cscnitc/RP2040-Based-Fault-Injection-Tool/pcb/gerbers&schematics/Schematic.pdf

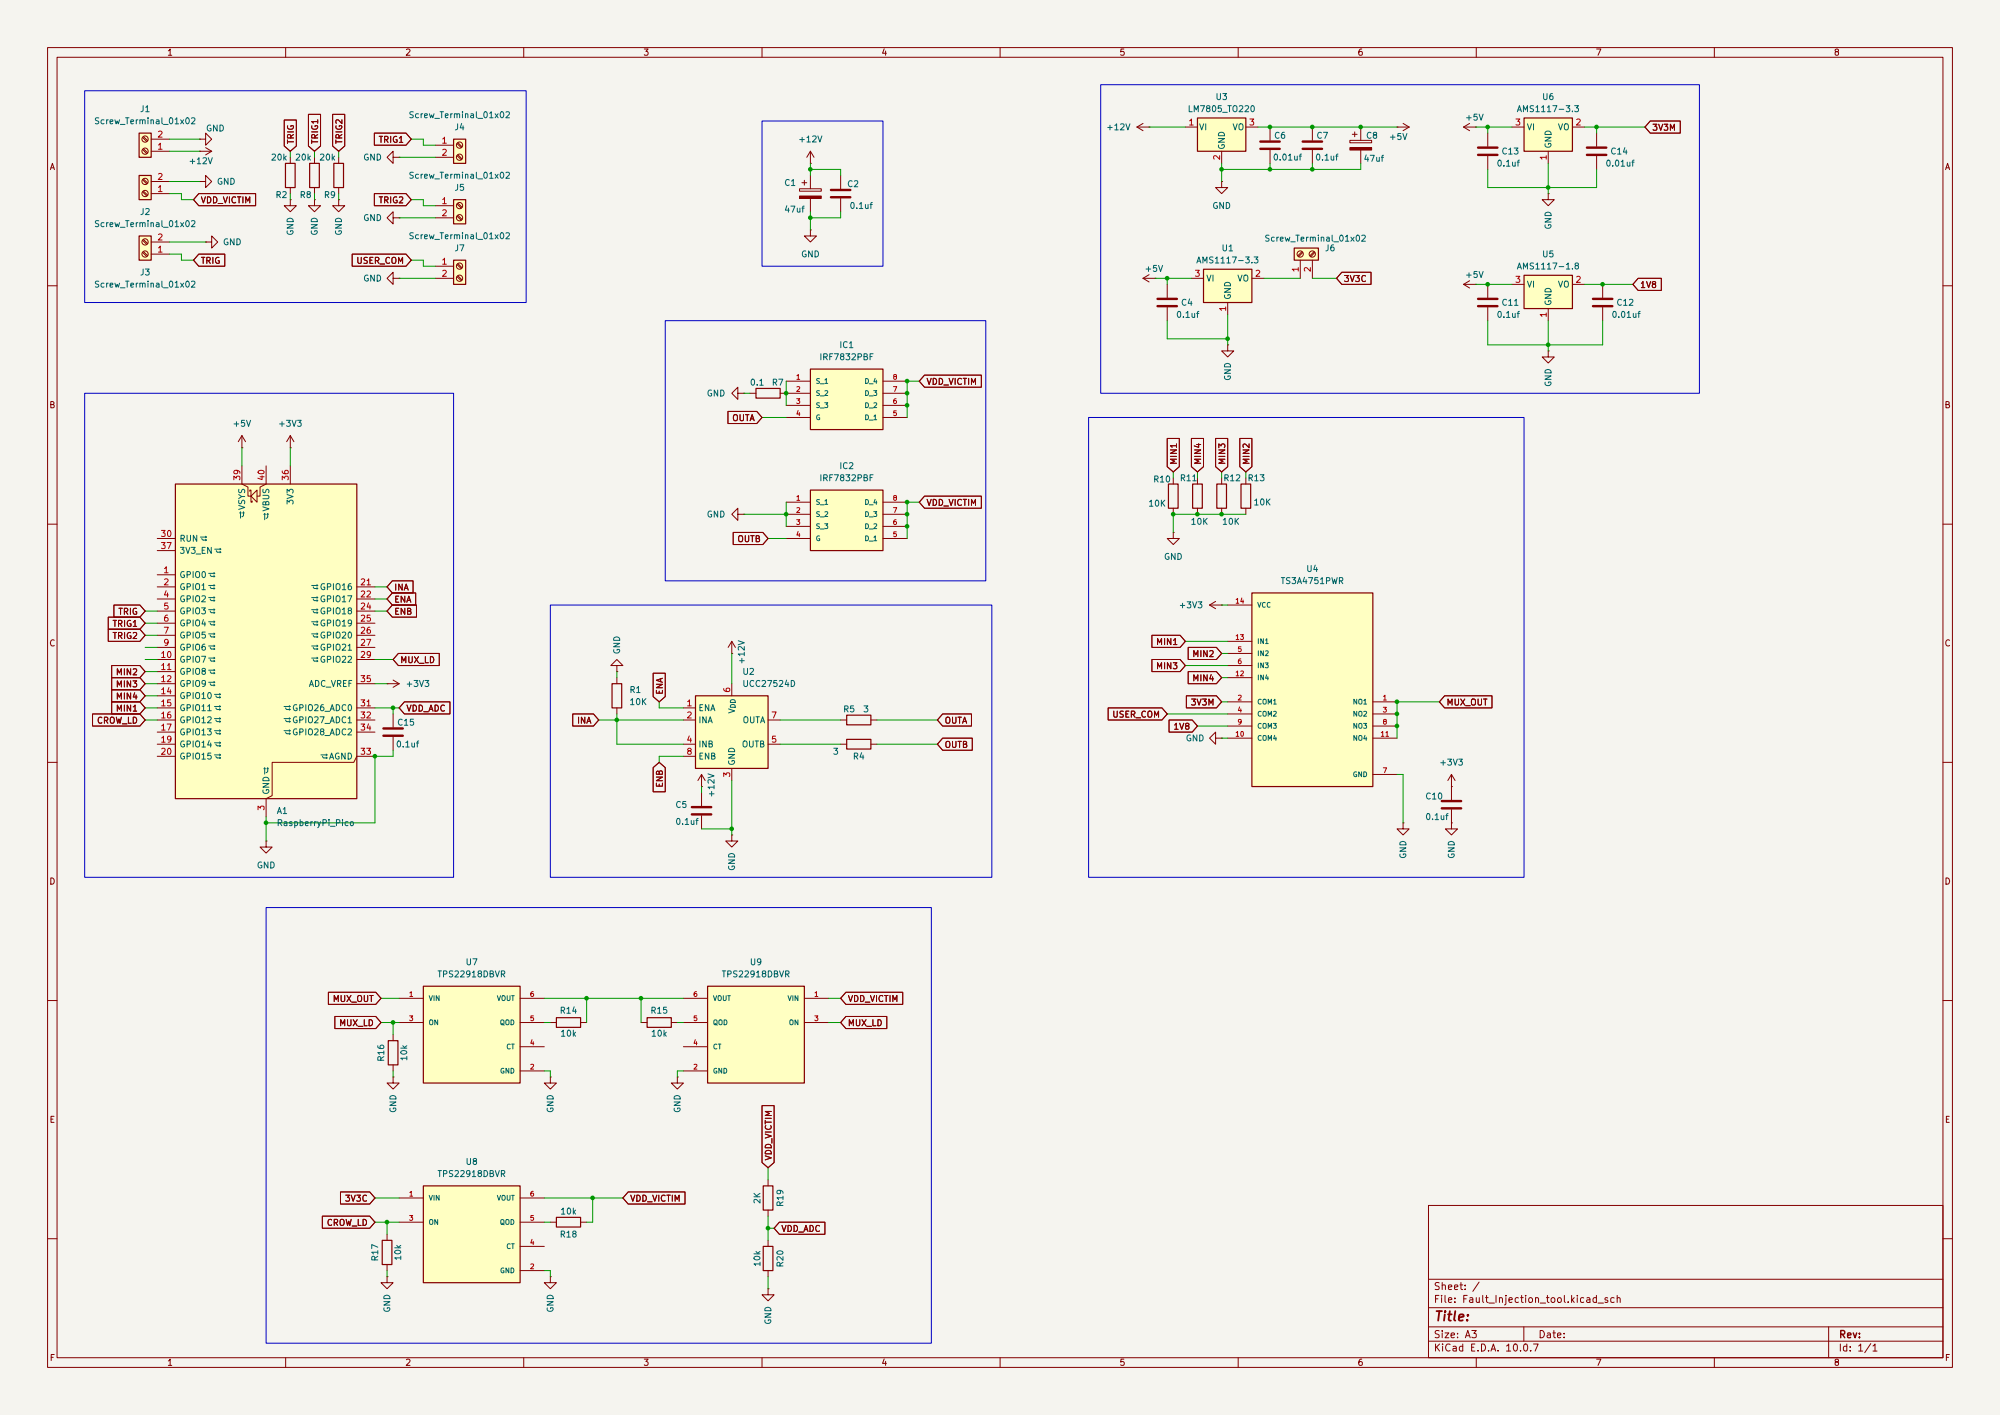
[picture p1: page 1]
