cscnitc/RP2040-Based-Fault-Injection-Tool/pcb/Fault_Injection_tool.kicad_pcb

## KiCad design pcb/Fault_Injection_tool.kicad_pcb (2026-11-07)

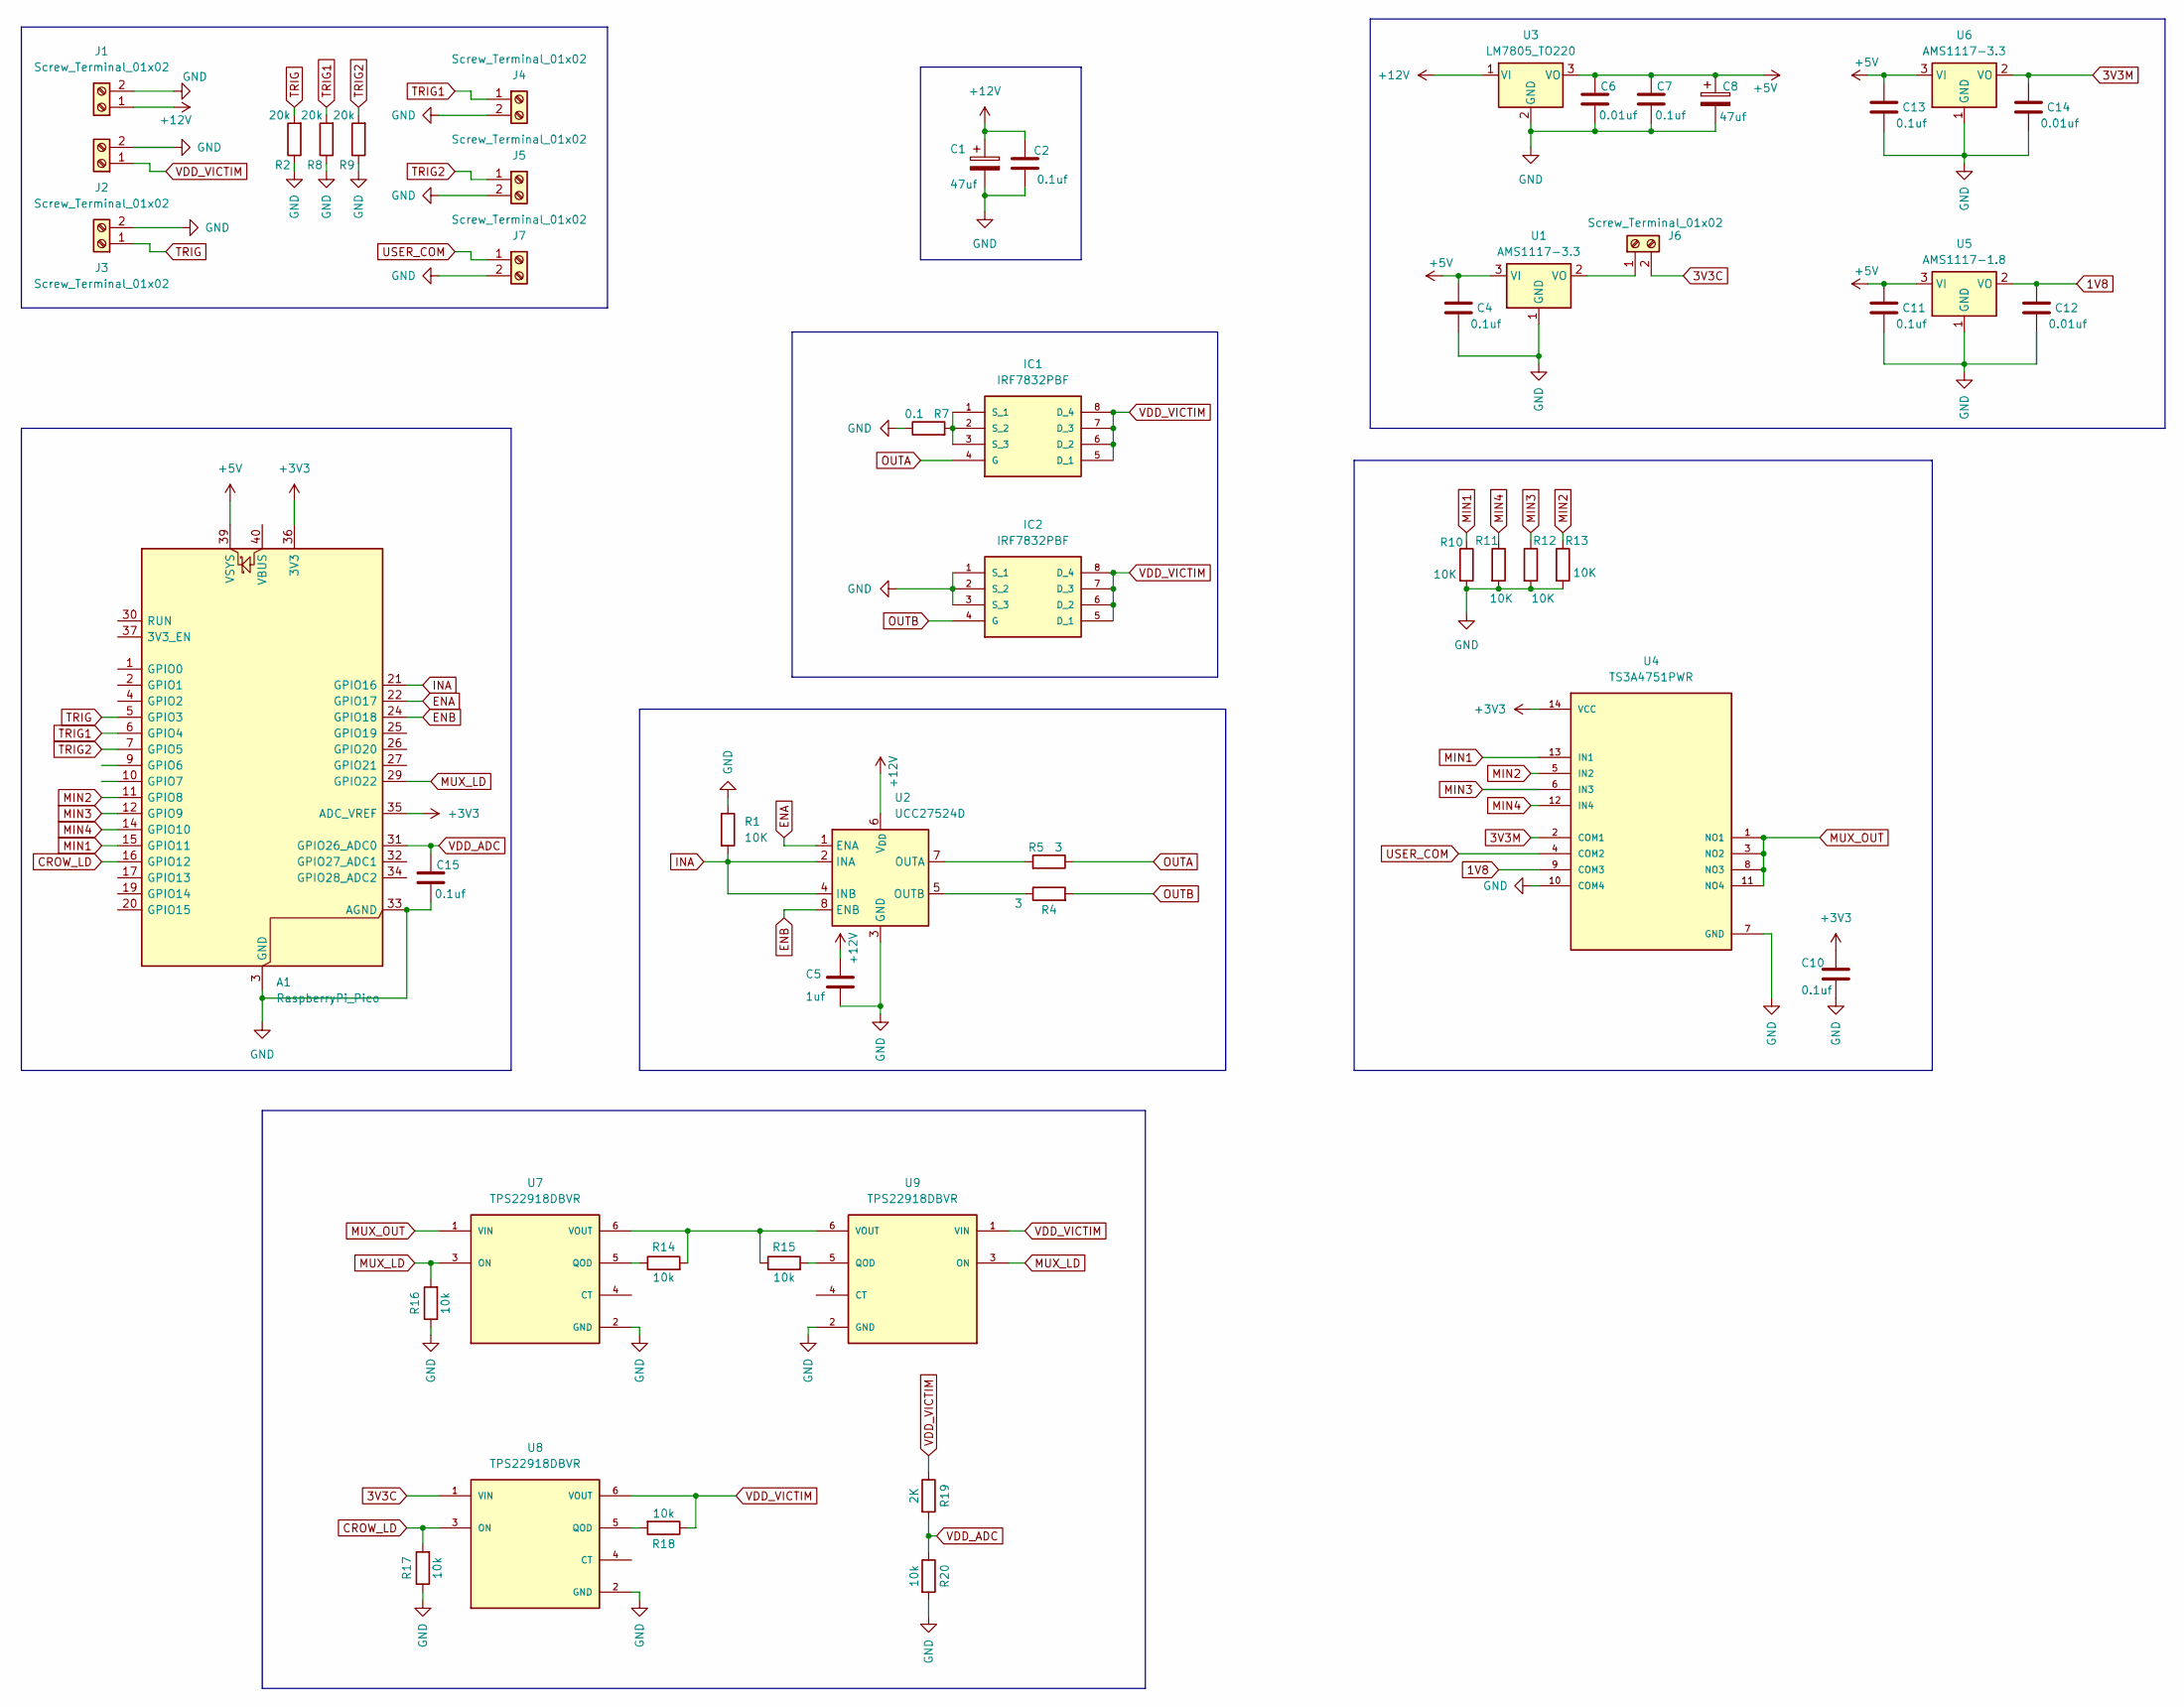
[picture p2: schematic Fault_Injection_tool.kicad_sch]

Parts:
A1: RaspberryPi_Pico; RaspberryPi_Pico_Common_THT
C1, C8: 47uf; C_Radial_D4.0mm_H7.0mm_P1.50mm
C2, C4, C7, C10, C11, C13, C15: 0.1uf; C_0805_2012Metric_Pad1.18x1.45mm_HandSolder
C5: 1uf; C_0805_2012Metric_Pad1.18x1.45mm_HandSolder
C6, C12, C14: 0.01uf; C_0805_2012Metric_Pad1.18x1.45mm_HandSolder
IC1, IC2: IRF7832PBF; SOIC127P600X175-8N; MOUSER_PART_NUMBER 942-IRF7832PBF
J1, J6, J7: Screw_Terminal_01x02; TerminalBlock_Xinya_XY308-2.54-2P_1x02_P2.54mm_Horizontal
J2, J3, J4, J5: Screw_Terminal_01x02; PinHeader_1x02_P2.54mm_Vertical
R1, R10, R11, R12, R13: 10K; R_0805_2012Metric_Pad1.20x1.40mm_HandSolder
R2, R8, R9: 20k; R_0805_2012Metric_Pad1.20x1.40mm_HandSolder
R4, R5: 3; R_0805_2012Metric_Pad1.20x1.40mm_HandSolder
R7: 0.1; R_Axial_DIN0411_L9.9mm_D3.6mm_P12.70mm_Horizontal
R14, R15, R16, R17, R18, R20: 10k; R_0805_2012Metric_Pad1.20x1.40mm_HandSolder
R19: 2K; R_0805_2012Metric_Pad1.20x1.40mm_HandSolder
U1, U6: AMS1117-3.3; SOT-223-3_TabPin2
U2: UCC27524D; SOIC-8_3.9x4.9mm_P1.27mm
U3: LM7805_TO220; TO-220-3_Vertical
U4: TS3A4751PWR; SOP65P640X120-14N; PARTREV F
U5: AMS1117-1.8; SOT-223-3_TabPin2
U7, U8, U9: TPS22918DBVR; SOT95P280X145-6N; PARTREV C

Connections:
1V8: C12.1, U4.9 (COM3), U5.2 (VO)
3V3C: J6.2, U8.1 (VIN)
3V3M: C14.1, U4.2 (COM1), U6.2 (VO)
+3V3: A1.35 (ADC_VREF), A1.36 (3V3), C10.1, U4.14 (VCC)
+5V: A1.39 (VSYS), C4.1, C6.1, C7.1, C8.1, C11.1, C13.1, U1.3 (VI), U3.3 (VO), U5.3 (VI), U6.3 (VI)
+12V: C1.1, C2.1, C5.1, J1.1, U2.6 (V_{DD}), U3.1 (VI)
CROW_LD: A1.16 (GPIO12), R17.2, U8.3 (ON)
ENA: A1.22 (GPIO17), U2.1 (ENA)
ENB: A1.24 (GPIO18), U2.8 (ENB)
GND: A1.3 (GND), A1.8 (GND), A1.13 (GND), A1.18 (GND), A1.23 (GND), A1.28 (GND), A1.33 (AGND), A1.38 (GND), C1.2, C2.2, C4.2, C5.2, C6.2, C7.2, C8.2, C10.2, C11.2, C12.2, C13.2, C14.2, C15.2, IC2.1 (S_1), IC2.2 (S_2), IC2.3 (S_3), J1.2, J2.2, J3.2, J4.2, J5.2, J7.2, R1.1, R2.1, R7.1, R8.1, R9.1, R10.2, R11.2, R12.2, R13.2, R16.1, R17.1, R20.2, U1.1 (GND), U2.3 (GND), U3.2 (GND), U4.7 (GND), U4.10 (COM4), U5.1 (GND), U6.1 (GND), U7.2 (GND), U8.2 (GND), U9.2 (GND)
INA: A1.21 (GPIO16), R1.2, U2.2 (INA), U2.4 (INB)
MIN1: A1.15 (GPIO11), R10.1, U4.13 (IN1)
MIN2: A1.11 (GPIO8), R13.1, U4.5 (IN2)
MIN3: A1.12 (GPIO9), R12.1, U4.6 (IN3)
MIN4: A1.14 (GPIO10), R11.1, U4.12 (IN4)
MUX_LD: A1.29 (GPIO22), R16.2, U7.3 (ON), U9.3 (ON)
MUX_OUT: U4.1 (NO1), U4.3 (NO2), U4.8 (NO3), U4.11 (NO4), U7.1 (VIN)
unnamed: IC1.1 (S_1), IC1.2 (S_2), IC1.3 (S_3), R7.2
unnamed: J6.1, U1.2 (VO)
unnamed: R5.2, U2.7 (OUTA)
unnamed: R4.1, U2.5 (OUTB)
unnamed: R14.1, U7.5 (QOD)
unnamed: R14.2, R15.1, U7.6 (VOUT), U9.6 (VOUT)
unnamed: R18.2, U8.5 (QOD)
unnamed: R15.2, U9.5 (QOD)
OUTA: IC1.4 (G), R5.1
OUTB: IC2.4 (G), R4.2
TRIG: A1.5 (GPIO3), J3.1, R2.2
TRIG1: A1.6 (GPIO4), J4.1, R8.2
TRIG2: A1.7 (GPIO5), J5.1, R9.2
USER_COM: J7.1, U4.4 (COM2)
VDD_ADC: A1.31 (GPIO26_ADC0), C15.1, R19.2, R20.1
VDD_VICTIM: IC1.5 (D_1), IC1.6 (D_2), IC1.7 (D_3), IC1.8 (D_4), IC2.5 (D_1), IC2.6 (D_2), IC2.7 (D_3), IC2.8 (D_4), J2.1, R18.1, R19.1, U8.6 (VOUT), U9.1 (VIN)

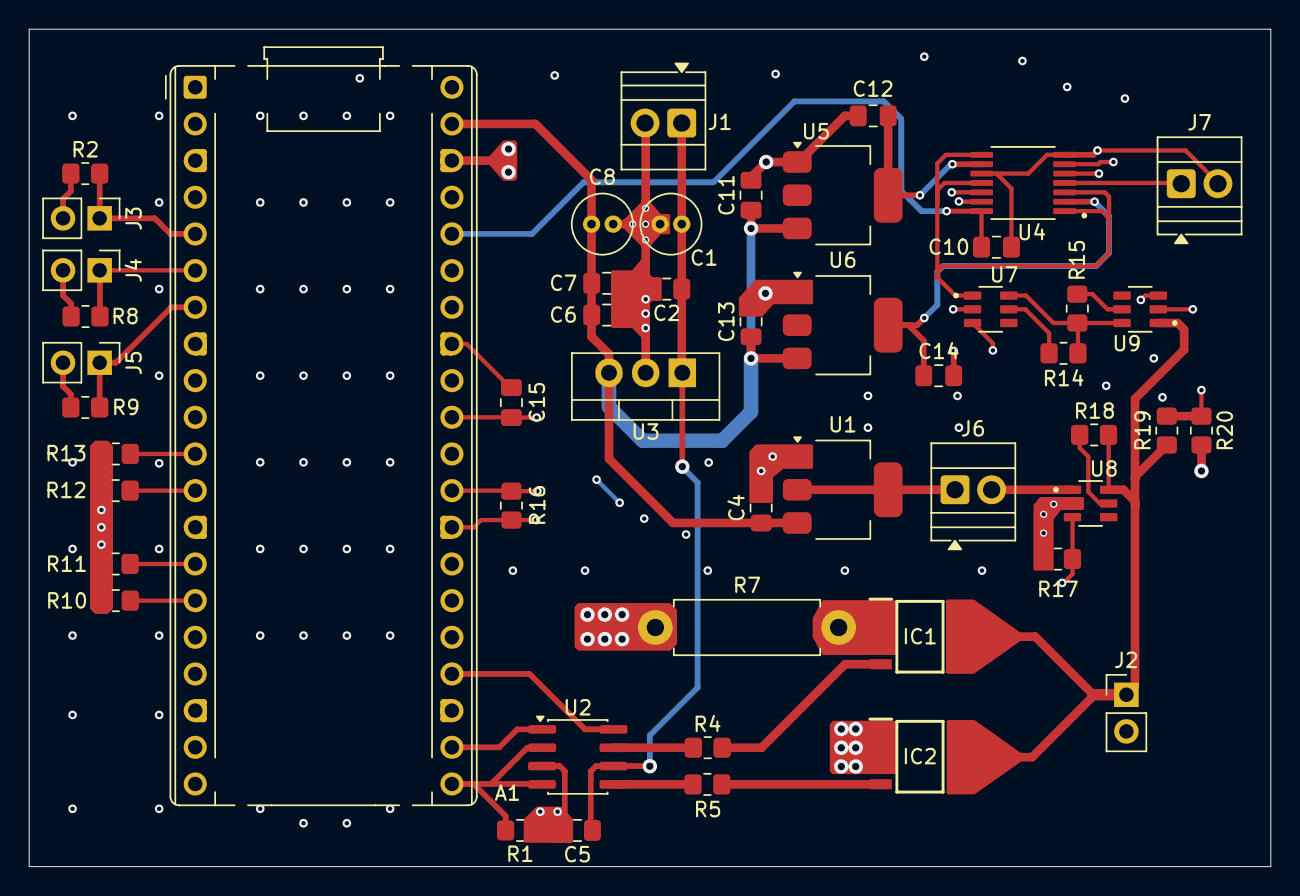
[picture p3: board Fault_Injection_tool.kicad_pcb from above]

Board: 4 copper layers, 86.0 x 58.0 mm, 50 parts (0 on the bottom side), 33 nets.
